mcer12/Hugo-ESP8266/Images/ap_screen.png

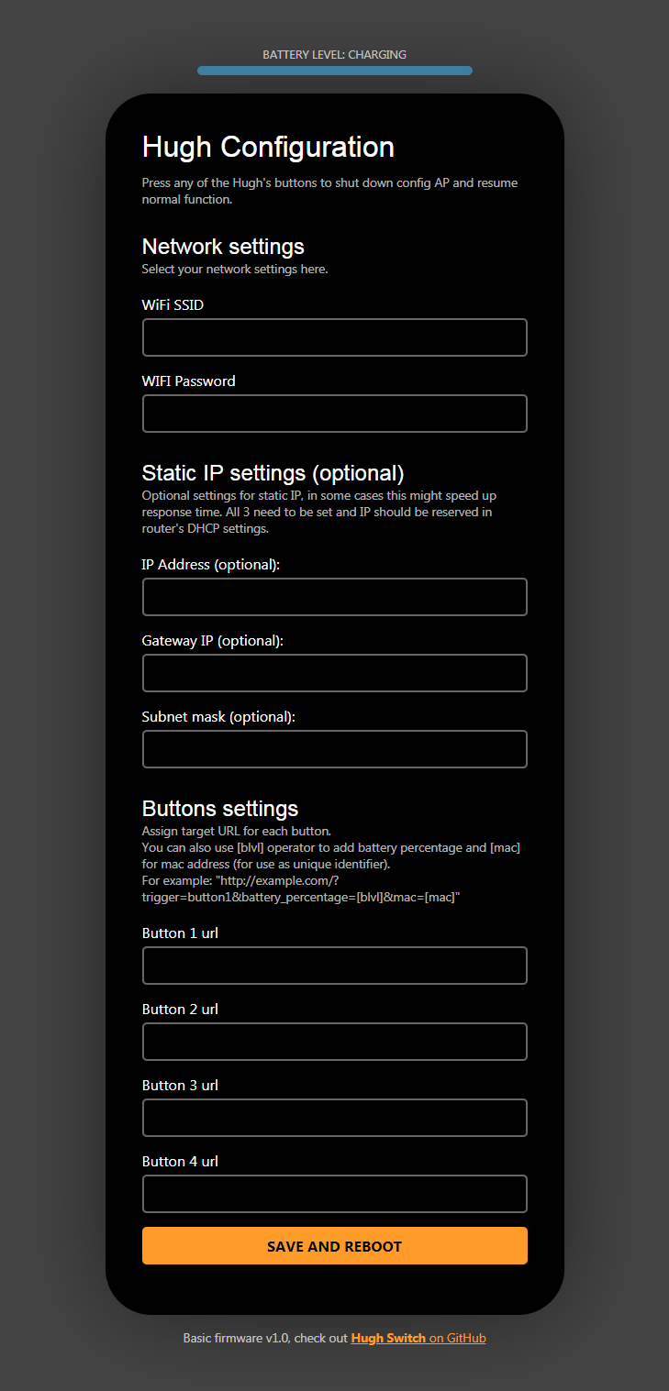
Images/ap_screen.png
