mcer12/Hugo-ESP8266/Images/ide_settings.png

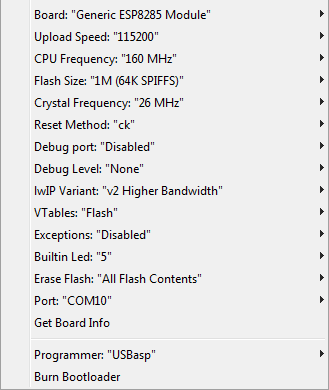
Images/ide_settings.png
