mcer12/Hugo-ESP8266/Images/ide_settings_2.6.3.png

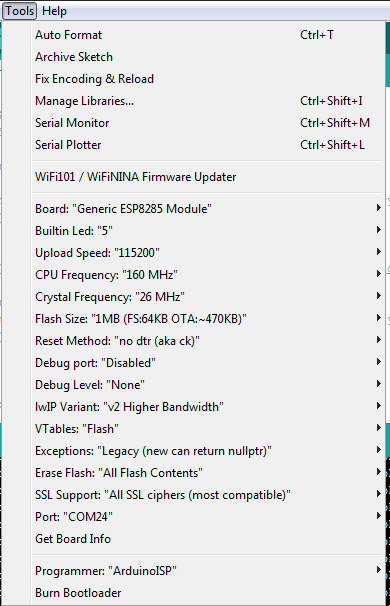
Images/ide_settings_2.6.3.png
