mcer12/Hugo-ESP8266/Resources/hugo_components.xlsx

PCB MARKING | COMPONENT | NOTES | component | pcs needed
ESP-M2 | ESP-M2 |  | ESP-M2 | 1
R1 | 0603 100K |  | 402050 lipo | 1
R2 | 0603 100K |  | CH340E | 1
R3 | 0603 10K |  | 7343 470uF | 1
R4 | - |  | 0603 10uF | 6
R5 | 0603 100K | 4.7uF + 150K combo should work just as well | SOD-323 1N5819 | 14
R6 | 0603 100K |  | 4x4x1.5mm smd button | 4
R7 | 0603 100K |  | TP4056 | 1
R8 | 0603 100K |  | 0603 100K | 6
R9 | 0603 100R-1K | Status led - depends on color of the led (orange, red = 330R) | HT7333 LDO | 1
R10 | 0603 - 4-10K | Charge current adjustment - 5K (recommended) or see table below. Don't use less than 3K otherwise the diode will overheat. | 0603 0.1uF | 4
R11 | - |  | MicroUSB connector | 1
R12 | 0603 100R-1K | battery full led - depends on color of the led (100R-200R for green) | 0603 1K | 4
R13 | 0603 100R-1K | charging led - depends on color of the led (680R-1K for red) | 2N2222 | 4
R14 | 0603 - 10K |  | 0603 1uF | 1
R15 | 0603 - 10K |  | AO3401 | 1
R16 | 0603 - 680K-820K |  | 0603 100R | 1
R17 | 0603 - 200K |  | 0603 330R | 1
R18 | 0603 10k |  | 0603 - 5K | 1
C1 | 0603 0.1uF |  | 0603 - 680K | 1
C2 | 0603 10uF |  | 0603 - 200K | 1
C3 | 0603 10uF |  | 0603 LED ORANGE | 1
C4 | 7343 tantalum 470uF or higher |  | 0603 LED RED | 1
C5 | 0603 0.1uF |  | 0603 LED GREEN | 1
C6 | 0603 10uF
C7 | 0603 10uF
C8 | 0603 10uF
C9 | 0603 10uF
C10 | 0603 0.1uF
C11 | 0603 0.1uF
C12 | 0603 1uF
D0-D13 | SOD-323 1N5819 or similar | for D10 you can use SOD-123 package if using high charge current
T1-T4 | 2N2222 | T3,T4 are optional, only in use with ch340
F1 | AO3401
LDO | HT7333 or similar low quiescent current LDO | MCP1700T is an option
BUTTONS | 4x4x1.5mm smd button (all metal)
LED1 | 0603 LED | status led, GPIO5
LED2 | 0603 LED | battery full led - suggested green color
LED3 | 0603 LED | charging indicator - suggested red
TP4056 | TP4056
CH340E | CH340E
USB | 4 legs through-hole 5pin microusb connector
BATTERY | lipo cells 402050 or smaller
YELLOW = OPTIONAL, USB TO SERIAL CONVERTER
GREEN = OPTIONAL, VOLTAGE DIVIDER FOR BATTERY MANAGEMENT
ORANGE = BUTTONS
RPROG (k) (R10) | IBAT (mA)
10 | 130
5 | 250
4 | 300
3 | 400
2 | 580
1.66 | 690
1.5 | 780
1.33 | 900
1.2 | 1000
