mcer12/Hugo-ESP8266/(threads)

Thread 6 (2019-08-09):

Battery reporting topics

giddyhup, 2019-08-09:
Great soft- and hardware! Apparently, a Hugo reports its battery level under two topics, is this on purpose? Also, 0x3e is 62 not 90, what does it stand for?

```
esp/hugh/battery 3e
esp/hugo/battery 90

```
I use two Hugos. It would make sense to have the status topics configurable through the web interface.

mcer12, 2019-08-13:
Sorry for getting back to you so late, I didn't receive a notification... this is a bug and will be solved in the upcoming update. I'll comment here once its pushed in the git.

mcer12, 2019-08-17:
@giddyhup This should also be fixed with the latest sketch.

giddyhup, 2019-08-17:
Thanks for the update. The line `publishBatteryLevel();` is missing in the code for button 1.

mcer12, 2019-08-17:
Thanks, you're correct. I pushed your solution.
I will add an option for custom topic in the next update.

giddyhup, 2019-08-18:
Good idea. In my case I named my two Hugos (red and black) and put the respective names in the topics.

mcer12, 2019-08-24:
@giddyhup Check out the latest update, it's a bigger one.

giddyhup, 2019-08-24:
Thanks. I will check it out when I return from my trip in a couple of weeks. Meanwhile, I'll close this issue.

Closed 2019-08-24.

Thread 8 (2019-08-26):

Hugo_MqttTrigger Access Point connection error

dimosap, 2019-08-26:
Hello,

I am a fan of your work and i'm testing your Hugo_MqttTrigger code on an esp12e module i own. Unfortunately i have the following problem. The access point appears only for some seconds and i'm not able to connect to it. After that it disappears from the available networks. Any ideas on the cause of this?

Thank you in advance.

mcer12, 2019-08-26:
Hi, this is very unusual and I didn't encounter anything like that. Few things to check off the top of my head.
1. Did you erase flash (all flash contents) when flashing the esp?
2. Are u using sufficient and stable power supply?
3. Is it possible the device you're using to connect to the AP is at fault? Try different one.
4. Do you have a nodemcu/wemos devboard at hand to try the sketch on? Just to check if the issue is not with the module.

I don't know the hookup scheme you have so it's really difficult to pinpoint what might be the issue. Try the above suggestions and if that doesn't help, try to provide me more details on your setup.

mcer12, 2019-08-26:
Oh and it can be caused by the button being still pushed down, for whatever reason. Maybe you didn't hook up the buttons at all and they are floating, maybe you have too large capacitor and it keeps the button pushed for too long. After 3 seconds after starting the config AP, program checks the buttons and if any of them is pushed, AP shuts down.

dimosap, 2019-08-26:
Thanks for your fast response,
I program the esp12e through an FTDI. I don't use other parts but only an ams1117 and buttons. I've also tested it with a nodemcu and a different device to test the connection but i came across the same results.

mcer12, 2019-08-26:
Did you check out my second post too? I think it's very likely to be the issue. Maybe try the buttons without the capacitor and make sure the pulldowns are in place. You will have to hold a button for half a second for it to get recognised but if my theory is correct, the AP won't disappear. This would mean the capacitance is too high, also esr can come into play here so use ceramics.

dimosap, 2019-08-26:
It finally worked!!!
The problem was that I had not connected all the buttons. Now I need to figure out where to put the link from ifttt trigger in the Hugo Configuration.
Thank you a lot for your help, your work is amazing!

mcer12, 2019-08-26:
Glad I could help!

Closed 2019-08-26.

Thread 9 (2019-08-27):

MQTT TLS support

juzam, 2019-08-27:
First of all, thanks for this nifty little gadget, I really like mine. I'm using it with the MQTT firmware 1.3b which added username and password support.

My only desiderata at this point would be support to connect to a secure MQTT broker (with optional client verification).

Would it be hard to implement this? more importantly, would it fit in the maximum space/memory constraints?

Thank you again for your time and effort spent on the project.

mcer12, 2019-08-27:
Hi @juzam I don't currently have the means to do this, I don't use tls at home, I have separate wifi network for IoT so I don't really have a reason to. But it shouldn't be too difficult to implement, it should fit since current sketch uses only around 40% memory but OTA will probably not work since it needs 50% free space. Check this out:
https://github.com/knolleary/pubsubclient/issues/462
Of course any contribution is appretiated!

juzam, 2019-08-27:
Thanks for providing that link, I think I can do some tests with that. I'll report here my findings.

mcer12, 2019-10-10:
Hi @juzam have you made any progress with the TLS?

juzam, 2019-10-10:
I'm so sorry but I didn't have any spare time to work on TLS support.  What I've seen from the link you posted is that `WifiClientSecure` could be an almost drop-in replacement for `WifiClient`. I hope to get some spare time during the weekend to do some tests in that regard.

juzam, 2019-10-21:
I had some time to work on this during the weekend but I still don't have anything usable. I've also realized that having just one remote doing the compile/upload/reconfigure/test cycle is very time consuming. I'm waiting for an esp8285 to be delivered to ease the process.

meanwhile I've setup up a fresh mosquitto broker with let's encrypt certificates to start with a clean slate.

mcer12, 2019-10-21:
@juzam you can use any ESP8266 module or devboard, it's fully compatible with esp8285 ;)

juzam, 2019-12-16:
a little update. I'm stuck at not being able to connect to a tls secured broker. I've tried a simple apporach with a very stripped down arduino sketch to no avail. What I'll do next is take a closer look on how `Tasmota` deals with mqtt and tls. They are using ``` #include <t_bearssl.h>``` to do so.

also, apologies for my perennial lack of time to work on this.

Darkmelman, 2020-08-13:
@juzam and @mcer12 Some time ago I implemented a very similar project myself with an Adafruit Huzzah32 and tls support. I think you could take over the parts of the source code that concern tls and WifiClientSecure

[https://github.com/Darkmelman/mqtt_button.git](url)

As soon as I have the time, I will be happy to support you

mcer12, 2020-08-13:
Hopefully @juzam will be able to use that, thank you for the hint! Though I don't use TLS in mqtt and don't have time to dig into it, I will accept PR if you decide to contribute!

I see you use adafruit mqtt library, did you have any particular reason for that? I ask because this would probably not fit within ESP-M2 memory together with pubsub client and it would have to be made as a separate sketch ;) I had to optimize quite a bit to squeeze HTTP + HTTPS capability in url trigger sketch.

Thread 11 (2019-10-27):

RFE : include printed MAC address on devices, web config interface

MagicFab, 2019-10-27:
It would be very useful to know the MAC address in order to be able to assign a static IP address before the first connection.
I'd like to suggest including the MAC address of each device in printed documentation or sticker on the device/static bag it comes in. This should also be displayed in the Hugo web configuration.

mcer12, 2019-10-27:
Hi @MagicFab at this point, the MAC address is appended to OTA name, I think the easiest approach is to append lets say last 6 characters to config SSID. Something like HugoXXXXXX instead of HugoConfig.
I will close the issue and let you know once it's done.

MagicFab, 2019-10-28:
Sorry I wasn't clear, I was not referring to the OTA name but to actually showing it in the web UI at http://10.10.10.1.

mcer12, 2019-10-28:
Yes this is a good idea, I will add it somewhere in the config portal.

mcer12, 2019-10-30:
MAC address was added in config portal as well as in config portal SSID, check out latest fw!

MagicFab, 2019-10-31:
Thank you! I've upgraded the firmware on one of the remotes I have and the MAC address is now show, most excellent!

Closed 2019-10-30.

Thread 13 (2019-10-27):

Battery topic is not included in the discovery (doHassRegister() ) function

mikeage, 2019-10-27:
Calling doHassRegister() sends a config topic for the state, but doesn't include battery information.

I'll try to submit a PR once I get an environment for flashing set up.

mikeage, 2019-10-27:
I'm having trouble flashing a new version (see #14 ), but here's a discovery string sample for battery (assuming the default topics); this one should be posted to `homeassistant/sensor/hugo_bd2916/battery/config`
```
{"unit_of_measurement":"%","device_class":"battery","state_topic":"homeassistant/sensor/hugo_bd2916/battery","name":"Hugo bd2916 Battery","unique_id":"hugo_battery_bd2916","device":{"ids":"hugobd2916","name":"Hugo - WiFi remote","mf":"https://github.com/mcer12/Hugo-ESP8266", "mdl":"Hugo-ESP8266","sw":"1.3"}}'
```
This is in conjunction with a regular discovery string of:
```
{"unique_id":"hugo_bd2916","name":"Hugo bd2916","stat_t":"homeassistant/sensor/hugo_bd2916/state","ic":"mdi:remote","exp_aft":"1","device":{"ids":"hugobd2916","name":"Hugo - WiFi remote","mf":"https://github.com/mcer12/Hugo-ESP8266", "mdl":"Hugo-ESP8266","sw":"1.3"}}
```
The device ID is the same, so they're linked in HA, but there's a unique `unique_id` for the battery sensor.

mcer12, 2019-10-27:
Hi @mikeage yes, currently battery state is not included in the discovery, this is one of the priorities for the next release. It should be ready sometime during next week, will keep you posted.

mikeage, 2019-10-27:
Ok, cool. Figured  I’d try to help a bit, but I’m not yet at the stage to submit a PR...

mcer12, 2019-11-03:
Check out latest commit, all you have to do is register Hugo again for it to update the configuration. Your suggested payload was a great help.

Closed 2019-11-05.

Thread 14 (2019-10-27):

Trouble flashing OTA

mikeage, 2019-10-27:
Hi,
I realize this might be a generic Arduino question; most of my experience is with platformio, and I'm not completely comfortable in the Arduino GUI.

I've made a small change to the code, compiled it, put the Hugo into OTA mode by pressing buttons 1+3 (rapid flashing), selected the network port, and selected Upload in the GUI. It says it's uploading, the LED becomes solidly lit, and then the Arduino GUI reports upload complete, but the LED stays lit and it seems like it did not accept the new .bin. If I push a button, any button, it seems to restart, but it does not appear to have loaded the new SW (tested by updating `#define FW_VERSION` and pressing buttons 2+4 to send the config string.

Any idea what I might be missing?

mcer12, 2019-10-27:
After the OTA finishes, it can still be processing the binary for few seconds. Just to be sure, by "not appear to have loaded the new SW" you mean the device is unresponsive or just acts like nothing happend?

mikeage, 2019-10-27:
I mean it stays with the LED lit for a while. If I press a button, it sends MQTT messages again, but with the old FW VERSION string.

mcer12, 2019-10-27:
Can you try to flash it again with the OTA? It might've been some kind of unusual hickup, usually if the OTA fails the device crashes. Also make sure to double chceck if all the options correspond with wiki page, if the settings were set wrong, binary might've been refused by the device:
https://github.com/mcer12/Hugo-ESP8266/wiki/Flashing-&-FW-update

Let me know how this goes, hopefully all is OK. Keep in mind though that OTA can fail from time to time and brick poor Hugo and since you have a version without CH340, this can get annoying :)

mikeage, 2019-10-27:
Sure (but probably not until tomorrow). I’ll let you know.

mcer12, 2019-11-03:
In case you didn't have time to try it out yet, check out latest commit, might interest you.

mikeage, 2019-11-03:
Thanks, I saw! I got pulled out of town on short notice and am now 2000km away from my devices :)

Closed 2020-07-20.

Thread 15 (2019-10-28):

Trouble registering Hugo to diyHUE/Hue app  - docs refers to "Sensors" section but there isn't any in the Hue app

MagicFab, 2019-10-28:
The documentation for pairing a Hugo remote with diyHue indicates:

> Push and hold buttons 2 + 4 until the led lights up, and release. This will register the remote in diyHue and it will pop up in Hue app, in Sensors section.

When I push and hold buttons 2 + 4 (assuming button "2" is under "O" and "4" is "I"), the led starts flashing fast. Is this indicating a registration attempt ?

The diyHue IP is properly configured in the Hugo remote. I was able to import lights into it from an existing Philips Hue bridge. I am not sure what is meant by "This will register the remote in diyHue", it doesn't show up anywhere I can see in the web UI. Can you provide more details ?

Regarding the Pillips Hue app, there isn't a "Sensors" section, only "Your rooms" in the Home section and "Accessory setup" under Settings. Could you please confirm where this is supposed to show up on the latest version of the app ? I tried 3.20.1.7162 and 3.31.0.7477.

mcer12, 2019-10-28:
Hi @MagicFab Do you use diyhue emulator or original hue bridge? Not sure how you come up with the numbering but the buttons are numbered from top to bottom so "I" is button 1, "O" is button 4 :) I will add this to wiki.

Yes Accessory is the correct menu. There might've been a change in Hue app, it was Sensors before.

MagicFab, 2019-10-28:
OK, thanks for clarifying the buttons. Perhaps the initial config/wifi connection can be a common section in the main documentation page where there is a picture, and identify the buttons on the picture. I am attaching such a miodified image, it's a GIMP XCF document with layers which you can modify (zipped, apparently Github doesn't like XCF) and a rendered jpeg image.

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

[hugo-buttons.zip](https://github.com/mcer12/Hugo-ESP8266/files/3779265/hugo-buttons.zip)

I am using diyHue as I don't expect the remote to register and show up on the other which is a the Philips bridge hardware device. In the Hue app both bridges are registered but I am connected to the diyHUe.

mcer12, 2019-10-30:
Double check if you entered the correct bridge IP and you are on the same network. Then push and hold buttons 2 and 4 until the led lights up for a second. Then it should pop up in the Hue app. Let me know how it goes.

mcer12, 2019-10-30:
I personally use diyhue at home so I've done this for all my remotes without issues. I would also check if the diyHue bridge is reachable using the IP address.

MagicFab, 2019-10-31:
Ok, so I had some time to check this again today.

After upgrading firmware for 2 of my devices and connecting them I tried the above with Philips Hue app and Hue essentials on one device. The remote appeared in both apps in the diyHUE, but not in its web interface (I don't think the UI shows any remotes)!

It appeared as a Hue Tap Switch under Settings > Accessory Setup. It's not ideal as it is a round-shaped remote, buttons 1,2,3 and 4 matched the same on Hugo and I was able to program them.

Another interesting fact, once I was finished I picked the other remote to set it up and when I touched button 1 it turned on the light... same as the other remote. The second remote is programmed the same as the first, yet it wa not registered to Hue. It seems the app thinks both remotes are the same (mirrored?).

I'll file a separate bug report, this one should be closed now. Thank you!

mcer12, 2019-10-31:
That would mean the remotes have the same MAC address which seems extremely unlikely. Maybe since you don't have it registered, diyHue doesn't know what to do and uses one of the already registered remotes. Try to register the second remote if you didn't do so already, that should solve it.

MagicFab, 2019-10-31:
OK, I'll be able to try that tonight - thanks!

mcer12, 2019-11-05:
Have you had time to try it out? If it's working as intended, please close the issue.

MagicFab, 2019-11-05:
Yes, I've tried this again after removing the registered remote and was unable to register either one of the remotes I have. I can't register it again, despite completely resetting both Hue bridge and diyHue bridge configurations completely and reflashing the devices. This worked once, never again.
What is the recommended way to reset the remote ? Is re-flashing enough ?

mcer12, 2019-11-05:
Oh I get it now! You don't have to reset the remote at all, this is diyHue issue with any remote (not just Hugo). Once you remove a remote from the app, it is still present in the diyHue config file. You have to manually remove the rmotes from diyHue file to *really* remove them and be able to register them again.  Wonder why this is still not fixed, I will add an issue on diyHue github page.

mcer12, 2019-12-16:
@MagicFab Latest diyHue version shoudl fix it but you will still have to remove the remotes from the config file or reset the diyHue to factory config.
https://github.com/diyhue/diyHue/commit/2c488808528924cd427f18bc9d473a76abd349b1

MagicFab, 2019-12-16:
OK, I never thought it would be a diyHue problem! I will be trying this again shortly - thank you!

Closed 2019-12-16.

Thread 22 (2019-11-05):

Button press issue

user-hash, 2019-11-05:
Hey, just got Hugo today and I entered the config details normaly.
I got the mqtt working, but since I was just trying I didnt know which button is which, so I decided I will upload the code again, to add diffrent button topics and such.
Code uploads normaly, and I can enter the config screen and set the information, but when remote reboots, its only registering combo button presses, even if 1 button is pressed.
Any ideas how can I solve this?

Here is the debug code I get, if I press the buttons from 1-4 in slow sequence, no combo button presses.
https://pastebin.com/wYSQja4F

mcer12, 2019-11-05:
Hi, this definitely shouldn't be happening. How fast are you pushing the buttons? You should make at least 1s delay between pushes, otherwise it can register it as a combo.

user-hash, 2019-11-05:
Please check the pastebin I posted above.
I press a single button 3 seconds after I get the "going to sleep" messege in the serial.
It only detects combo messeges..I can also record video, if you need it

mcer12, 2019-11-05:
In that case I suspect a hardware issue. This shouldn't be happening, please email me to investigate this further.

user-hash, 2019-11-05:
Hey, I hope you get this email, please confirm.
What information do you need from me?
Matic

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

Closed 2019-11-05.

Thread 25 (2019-12-05):

MQTT / Home Assistant / button topics

Zixim, 2019-12-05:
Hello,

just got 2 Hugos in the mail! I'm really chuffed, they feel like great little devices.

I flashed the MQTT firmware, made sure HA MQTT is configured for discovery (which it wasn't), and the Hugo device shows up under Integrations/MQTT in HA Configuration.
There's 2 entities , one for the status of the Hugo and one for the Battery.

I do have a couple of questions though:

Aren't all configured buttons supposed to show up in there ?
Why is the sensor for battery not showing any value ?

mcer12, 2019-12-05:
1) what do you mean by all buttons? Do you mean remotes or individual buttons on a single remote?
2) It only updates battery status together with a button topic. Maybe you didn't set up battery topic in web config?

Zixim, 2019-12-05:
I mean individual buttons, which I all set up in the web config as shown :

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

The button presses show up in MQTT Lens , as expected :
with topic `homeassistant/sensor/hugo_XXYYZZ/btn1` and payload `1`

The battery value never updates, and stays empty even after button presses.

mcer12, 2019-12-05:
You have to use example topics for all button topics as well as for battery topic for Home Assistant integration to work. See wiki:
https://github.com/mcer12/Hugo-ESP8266/wiki/Sketch:-MQTT
"homeassistant/sensor/hugo_[id]/state" for the buttons
"homeassistant/sensor/hugo_[id]/battery" for battery
I will add the note in config portal as well for more clarity in an upcoming update.

Zixim, 2019-12-05:
So the web config states :
`Assign MQTT Topic and Payload for each button, for example:
Topic: "homeassistant/sensor/hugo_[id]/state"
Payload: "1" `

What does that mean I should set for Button 1 topic & payload ?
And what about Button 2?

mcer12, 2019-12-05:
Don't overthink it, it's meant to be simple :)

B1
topic: homeassistant/sensor/hugo_[id]/state
payload: 1

B2
topic: homeassistant/sensor/hugo_[id]/state
payload: 2

etc......

Zixim, 2019-12-05:
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
Much better 😜

mcer12, 2019-12-05:
It's a common assumption that DIY products have to be difficult to set up, but I disagree :) Glad you managed to make it work! I did some edits to the wiki to make it a bit clearer.

Closed 2019-12-05.

Thread 26 (2020-02-15):

Is this product available anymore

ravi9884, 2020-02-15:
First of all sorry to spam in GitHub issues, but I had no choice as tindie wouldn't send an email to activate my account to contact seller.

I just ordered 3 from tindie, but it ran out of stock. I wanted to buy 2 more. Also, how would I replace the battery? Any link to buy similar battery

Thanks,
Ravi R

mcer12, 2020-02-15:
I believe this was answered on Tindie ;)

Closed 2020-02-15.

Thread 27 (2020-03-02):

Wiki suggestion: a script to make bulk configuration easier

sowbug, 2020-03-02:
It's tedious to configure multiple remotes. I wrote a simple script that makes it a little easier.

```
REMOTES = {
    "12:23:34:45:56:67": 100,
    "12:23:34:45:56:68": 101,
    "12:23:34:45:56:69": 102,
}

PARAMS = {
    "ssid": "myssid",
    "pass": "mypass",
    "ip": "192.168.2.",
    "gw": "192.168.2.1",
    "sn": "255.255.255.0",
    "broker": "192.168.2.100",
    "port": "1883",
    "mqttusr": "mqttusername",
    "mqttpass": "mqttpass",
    "b1t": "homeassistant/sensor/hugo_[id]/state",
    "b1p": "payload1",
    "b2t": "homeassistant/sensor/hugo_[id]/state",
    "b2p": "payload2",
    "b3t": "homeassistant/sensor/hugo_[id]/state",
    "b3p": "payload3",
    "b4t": "homeassistant/sensor/hugo_[id]/state",
    "b4p": "payload4",
    "b5t": "homeassistant/sensor/hugo_[id]/state",
    "b5p": "payload5",
    "b6t": "homeassistant/sensor/hugo_[id]/state",
    "b6p": "payload6",
    "b7t": "homeassistant/sensor/hugo_[id]/state",
    "b7p": "payload7",
    "batt": "homeassistant/sensor/hugo_[id]/battery",
}

import copy
from urllib.parse import urlencode

for mac, ip in REMOTES.items():
    p = copy.deepcopy(PARAMS)
    p["ip"] += str(ip)
    print("%s: curl -d \"%s\" 10.10.10.1\n\n" % (mac, urlencode(p)))
```

This will spit out a bunch of `curl` commands you can execute on the command line when you're connected to a remote in configuration mode. The curl command is the same as filling out the web form and hitting submit. As you can see, my remotes are flashed with the MQTT firmware. Modify the script for other kinds.

mcer12, 2020-03-02:
Hi @sowbug I like the idea but I wonder how do you find out mac address before you connect to the network? Probably it can be found in debug console but that doesn't seem to simplify things. Can you elaborate on the process?
What I do when I want to set up multiple remotes fast is connect to a remote in AP mode, save config and leave the config page open (with fields already filled in). Connect to another remote and just hit save. And repeat.

sowbug, 2020-03-03:
It's a two-pass operation. First, connect to each one and paste the MAC addresses into the script. Then start over again from the beginning and run the right generated curl script. Yeah, painful, I know.

I also started with the recycled web form, but once or twice I pressed submit a moment too early, before I'd gotten the DHCP assignment, and my browser wiped out all the fields. So I wanted something a little more predictable (including if I wanted to reflash the firmware in the future). Plus for various reasons it was helpful to have the list of MAC addresses when setting up the static addresses in my router, so once I compiled the list and noticed it looked a lot like a Python dict, the rest was quick.

To be clear, I'm not proud of this solution. But it did work!

Maybe a compromise would be an optional field on the form where you could paste JSON. You already have imported ArduinoJSON in the MQTT client, so it's not going to change the firmware size significantly.

mcer12, 2020-04-14:
Sorry to get to this so late, I will try to add a field for raw json in some reasonable way.

Now that I think about it, maybe it would be best to make two more url paths
**/download_json**
**/import_json**
One with a textarea where you can paste the json and second that will just return raw json content that you can download. Root / will return the config website as usual

sowbug, 2020-04-14:
Cool, no hurry for me in particular -- mine are set up and working fine.

Closed 2023-05-31.

Thread 28 (2020-05-23):

ESPHome Support

oldgeezy, 2020-05-23:
I just converted a bunch of my Tasmota devices to ESPHome, which looks like a great platform for managing all your ESP devices and OTA updates.  Is there any way we could get firmware support there for our switches?

mcer12, 2020-05-25:
Hi, since there are some unusual hardware specifics (buttons connected to wakeup, capacitors on buttons etc), you can't use ESPHome fw as is, you would have to make your own custom sketch to accomodate the above. If you would like to contribute with an ESPHome sketch, I will accept PRs, but I don't have the time to learn ESPHome as I don't personally use that platform at home... hope you understand :)

That said, if you use ESPHome with Home Assistant, you can use the MQTT sketch which works pretty well with HASS including auto-discovery.

Closed 2020-09-08.

Thread 30 (2020-07-20):

Suggestion

StefanRehnberg, 2020-07-20:
Hi
It would be a very nice feature if you could implement "multi click" on the buttons, like the [Shelly i3](https://shelly.cloud/knowledge-base/devices/shelly-i3/).

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

mcer12, 2020-07-20:
Hi @StefanRehnberg this is sadly not possible. It's not possible because of HW reasons, in the way it works, it is impossible to distinguish between longpress and two quick presses. And even if it was possible, this would lead to worse battery performance since the remote would have to wait for possible second push every time. That said, I am planning on adding a long press (which is long overdue) which I think is going to give you plenty of options. At this point, there are single pushes and two-button combos, so 7 possible functions. With longpress it will go up  to 11 :)

StefanRehnberg, 2020-07-21:
Excellent! thanks for the info, keep up the good work :-)

Closed 2020-07-21.

Thread 32 (2020-09-11):

HTTP (Basic URL trigger)

patrickdej, 2020-09-11:
Hello,
we have inserted an URL into the Hugo, but the request is executed as a TCP message and not as an http request (seen in wireshark)
Whats wrong?

URL set to this http://172.20.20.153:8080/#/Main/Acknowledge?Sendkey=T1_S1_G
when executing this URL from an phone on the same network (just past it into the browser), it works fine.
so no issue on firewall.
172.20.20.122 is the phone, TCP connection OK, http OK
172.20.20.170 is the Hugo ==> TCP NOK and thus no http transfer possible
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

thanks,

Patrick

mcer12, 2020-09-11:
Hi, I think this might have something to do with the port in your URL address. I never tried/needed this so this is probably what's the issue here. Lets start by removing the port from the URL address (so it will be 80 by default), see if it works.

patrickdej, 2020-09-18:
OK, works fine now. was due to the way the website worked, it needed more then only 1 url...
thanks!

Closed 2020-10-25.

Thread 33 (2021-01-08):

change firmware from URL to MQTT

patrickdej, 2021-01-08:
Hello,

We have been using the HUGO with the URL triggering and is working fine.
When we now want to change the firmware to the MQTT version, we get the following output, if we flash the URL version, all works fine. I'm quiet new to this, any direction where to go for finding a solution?

--------------- CUT HERE FOR EXCEPTION DECODER ---------------#LF#CR#LF ets Jan  8 2013,rst cause:2, boot mode:(3,7)#CR#LF#CR#LFload 0x4010f000, len 3584, room 16 #CR#LFtail 0#CR#LFchksum 0xb0#CR#LFcsum 0xb0#CR#LFv2843a5ac#CR#LF~ld#LF#CR#LFFW: MqttTrigger#CR#LFButton: 0#CR#LF#LF--------------- CUT HERE FOR EXCEPTION DECODER ---------------#LF#CR#LFException (28):#CR#LFepc1=0x4020554a epc2=0x00000000 epc3=0x00000000 excvaddr=0x00000000 depc=0x00000000#CR#LF#CR#LF>>>stack>>>#CR#LF#CR#LFctx: cont#CR#LFsp: 3ffffd80 end: 3fffffc0 offset: 0190#CR#LF3fffff10:  3fffdad0 3fff0618 3fff06f8 40205539  #CR#LF3fffff20:  feefeffe feefeffe feefeffe feefeffe  #CR#LF3fffff30:  feefeffe feefeffe feefeffe feefeffe  #CR#LF3fffff40:  feefeffe feefeffe feefeffe feefeffe  #CR#LF3fffff50:  feefeffe feefeffe feefeffe feefeffe  #CR#LF3fffff60:  feefeffe feefeffe feefeffe feefeffe  #CR#LF3fffff70:  00000000 00000000 3fff185f 3fff185f  #CR#LF3fffff80:  00000000 feefeffe feefeffe feefeffe  #CR#LF3fffff90:  feefeffe feefeffe feefeffe 3fff0828  #CR#LF3fffffa0:  3fffdad0 00000000 3fff07e8 4020defc  #CR#LF3fffffb0:  feefeffe feefeffe 3ffe84f4 40100da9  #CR#LF<<<stack<<<#CR#LF#LF--------------- CUT HERE FOR EXCEPTION DECODER ---------------#LF#CR#LF ets Jan  8 2013,rst cause:2, boot mode:(3,7)#CR#LF#CR#LFload 0x4010f000, len 3584, room 16 #CR#LFtail 0#CR#LFchksum 0xb0#CR#LFcsum 0xb0#CR#LFv2843a5ac#CR#LF~ld#LF#CR#LFFW: MqttTrigger#CR#LFButton: 0#CR#LF#LF--------------- CUT HERE FOR EXCEPTION DECODER ---------------

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

regards,

patrick

mcer12, 2021-01-08:
I bet it's crashing because you don't erase whole flash :) So first change Erase flash to "all flash contents". In case I'm wrong, you might have some outdated libraries or ESP8266 board definition so check if you have the latest versions.

mcer12, 2021-01-08:
Also set frequency to 160MHz, the performance should be better.

mcer12, 2021-03-08:
Closing as stale, feel free to reopen.

Closed 2021-03-08.

Thread 35 (2021-01-30):

DHCP does not wait long enough

hagenbuch, 2021-01-30:
Dear Mcer12,

I am using 4 of your Hugos (firmware 1.4.1) on a regular basis and it works mostly fine, but -

While using it (over time) with two different Wifi routers from the same manufacturer (AVM, Fritzbox 7430 and 7530 - the last is very modern) the device seems to not wait long enough for the DHCP reply so it blinks instead of sending data. This happens every 1 in 5 times, no matter how distant I am.

I have seen that the timeout is hardcoded in your main code (4 and 8 seconds?) I am not proficient enough to write a pull request but you might figure this out in seconds.

I understand that you don't want to wait for too long because it affects battery life. However, I would really appreciate if this timeout could be configurable in the webfrontend or at least could be set as global variable in the code.

I hope that makes sense for you, too :-)

Thank you for your product and for taking your time..
Andreas

mcer12, 2021-01-30:
It should not take so long to receive DHCP. I would guess something with the network is the culprit. Have you tried static IP?

mcer12, 2021-03-08:
Closing as stale, feel free to reopen.

Closed 2021-03-08.

Thread 36 (2021-05-25):

Possibly release gerber files now that product is retired?

nullstalgia, 2021-05-25:
I forgot to grab one while the last batch went up, and I wanted to maybe yoink the design you had.

If not, that's fine! Just thought I should ask. <3

mcer12, 2021-05-28:
I added the gerber, with all the usual disclaimers. But to be honest, at this point it makes more sense to use ESP32 as it has more GPIOs, much easier to work with deepsleep and it has half the power consumption in deep sleep. You can compensate for the ESP32 size with smaller component count. I personally switched over to ESP32 for most projects, except when I need it super tiny, where ESP-M2 makes more sense.

Closed 2021-05-28.

Thread 37 (2022-02-19):

not an issue, more a plea : Revive this project with esp32-c3 ?

Zixim, 2022-02-19:
The title says it all really...
There's this thing : https://github.com/makermoekoe/Picoclick-C3 , but it's far from user-friendly.
I've been using your Hugos for a few years now, and they're easy to config, run rock solid, integrate great with Home Assistant. No complaints at all.

So, a more modern esp32-c3 version, please ?

mcer12, 2022-02-20:
Hi, I don't see any issue with using ESP8266 - my hugos run prefectly fine and I don't see any meaningful benefit by using ESP32. If the ESP32 was 5GHz capable, that would be a different story.

That said, you can make the board yourself if you can solder, gerber, BOM and schematic are all in this repository :)

Zixim, 2022-02-20:
i'd prefer to purchase...8266 or 32 are equivalent in this usage case that's true.

ceoloide, 2022-02-21:
Shameless plug: a while ago I created an ESP-32 derivative of Hugo-ESP8622, aptly named [Ugo-ESP32](https://github.com/ceoloide/Ugo-ESP32).

That board uses a [TinyPICO](https://www.tinypico.com/) module, which uses almost no battery on low power mode. With a 1200mha battery I could get almost 2 years of standy time and over 500 button presses.

The ESP-32 gives more flexibility with encryption, so it supports both HTTPS and MQTTS endpoints at the same time.

JLCPCB now offers a wider variety of components for their SMD servive, so in theory one could order the Hugo-8266 through them directly and have it fully assembled.

Zixim, 2022-02-21:
This Tinypico thing is expensive - 22 usd ??

About JLCPCB + Hugo-ESP8266, I'm very tempted, but this is entirely new to me.
Even going through [the instructions included in Gerber_Hugo-ESP8266.zip](https://docs.easyeda.com/en/PCB/Order-PCB/), I'm left with way many questions, leading me to believe I'll never end up with a few useable devices.

I mean...it says : `1. Finish the schematic and PCB design at EasyEDA.`
But EasyEDA doesn't let me import the gerber files...

Slightly demotivated here...

mcer12, 2022-02-21:
You dont unzip the gerber díle, you upload it directly to jlcpcb ;)

Zixim, 2022-02-21:
Yea, that's what the web interface at JLCPCB told me... then it wants a CPL file, which I'm supposed to make in EasyEDA ?

Closed 2022-02-20.
