mcer12/Hugo-ESP8266/Resources/Hugo-ESP8266_schematic_2.3.pdf

## Voltage measurement

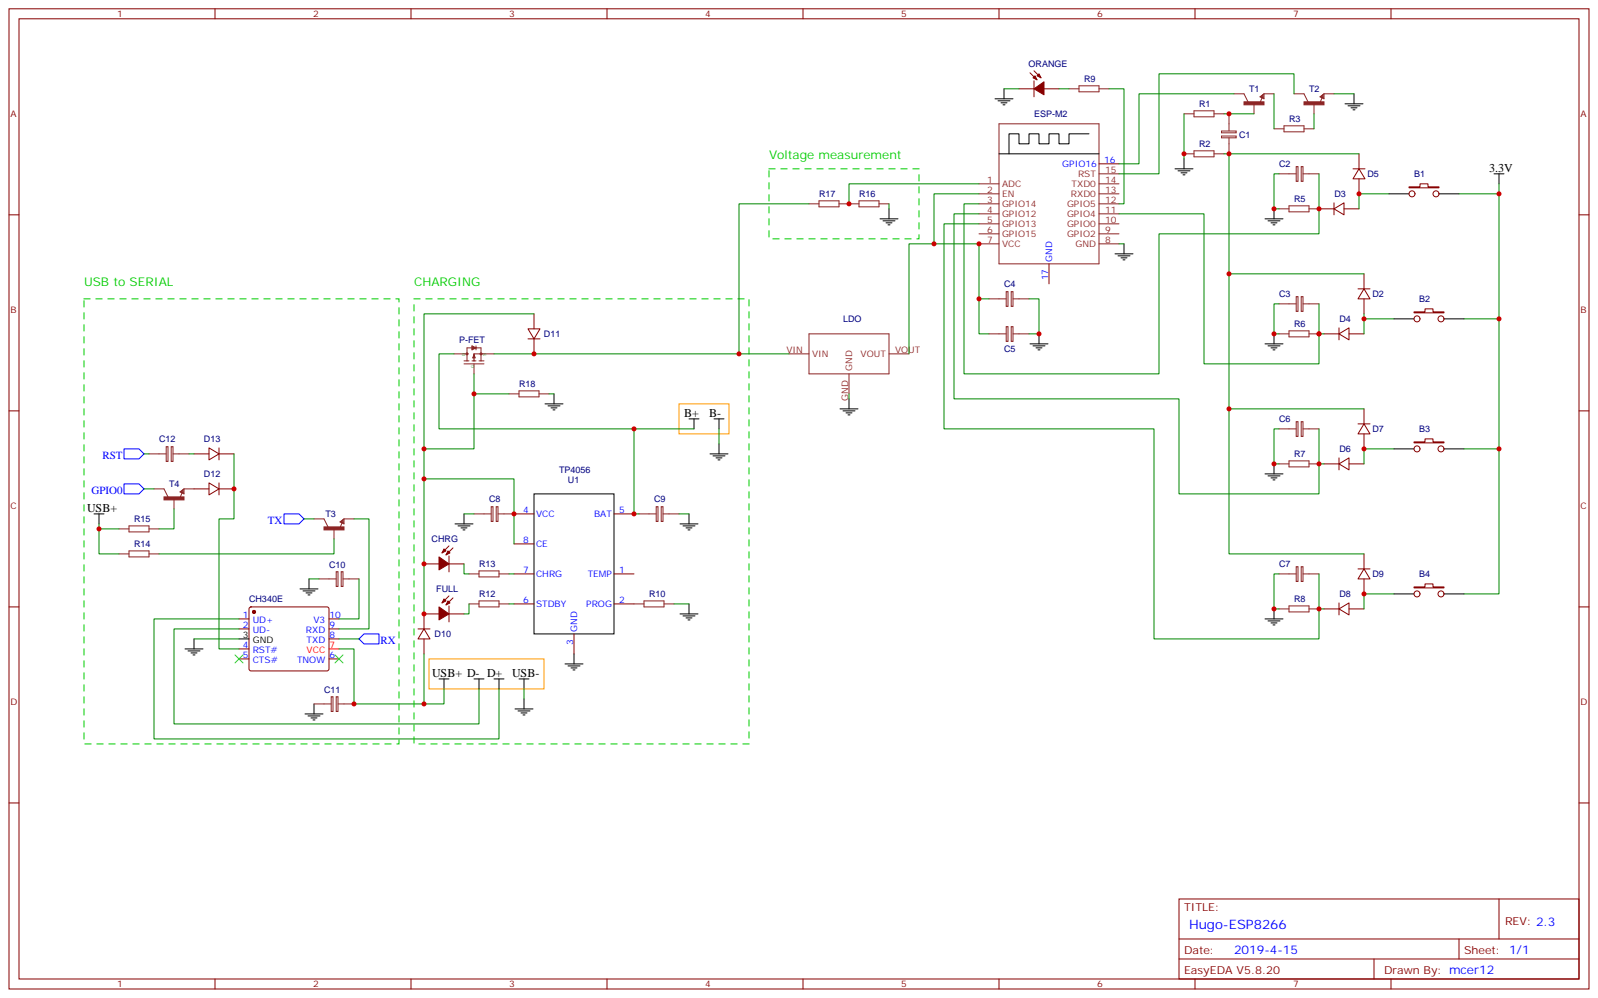
[picture p5: page 1]

GPIO13 5
GPIO15 6
