mcer12/Hugo-ESP8266/Firmware/HugoRGB_MqttTrigger/ota.ino

void setupOTA() {
  String ota_name = OTA_NAME + macLastThreeSegments(mac);
  ArduinoOTA.setHostname(ota_name.c_str());
  ArduinoOTA.begin();

  ArduinoOTA.onStart([]() {
    Serial.println("OTA UPLOAD STARTED...");
    stopBlinking();
    digitalWrite(5, HIGH);
  });

  ArduinoOTA.onError([](ota_error_t error) {
    (void)error;
    ESP.restart();
  });

  ArduinoOTA.onEnd([]() {
    Serial.println("OTA UPLOAD DONE...");
  });
}

void startOTA() {
  startBlinking(OTA_BLINK_SPEED);
  delay(5000);
  while (millis() - otaTimer < OTA_TIMEOUT) {
    if (digitalRead(button1_pin) == HIGH || digitalRead(button2_pin) == HIGH || digitalRead(button3_pin) == HIGH || digitalRead(button4_pin) == HIGH) {
      stopBlinking();
      goToSleep();
      return;
    }
    ArduinoOTA.handle();
    delay(20);
  }
  stopBlinking();
  goToSleep();
}

void toggleOTAMode() {
  if (digitalRead(button1_pin) == HIGH && digitalRead(button3_pin) == HIGH) {
    int i = 0;
    while (digitalRead(button1_pin) == HIGH && digitalRead(button3_pin) == HIGH && i < 200) {
      delay(10);

      if (i > 100) {
        deviceMode = OTA_MODE;
        otaTimer = millis(); // start counter
        return;
      }
      i++;
    }
  }
}
