mcer12/Hugo-ESP8266/(commit log)

2019-05-19 added battery level measurement
2019-05-19 removed serial prints, changed serial speed
2019-06-02 1. Wifi WL_CONNECTED checking hotfix, 2. diyHue sketch update, register function added, push and hold buttons 1 and 3 to add remote in Hue app
2019-06-03 1. Wifi connection timeout set to 4 seconds - this fixes "failed to connect" bug, 2. Added mac slip to OTA name to distinguish between remotes, 3. readme added in the sketches
    [Hugh_BasicUrlTrigger.ino, config_portal.ino, fns.ino]
2019-06-03 Button discharge hack removed, this can potentially damage GPIO
    [fns.ino]
2019-06-04 fix for AP connection issues on some devices
    [config_portal.ino]
2019-07-13 Device won't go to sleep anymore when new config file is created
    [fns.ino]
2019-07-13 Button combinations added
2019-07-13 config portal typo fix
    [config_portal.ino, fns.ino]
2019-07-13 Button combinations added in MQTT firmware
2019-07-31 components list added, some renaming done
    [hugo_components.xlsx]
2019-08-17 battery level topic fix
    [fns.ino]
2019-08-17 publish battery level when any of the buttons is pushed
2019-08-24 fixed mqtt login issues
    [fns.ino]
2019-08-24 small delay added between button and battery publish
2019-09-08 MQTT connection attempts count fix, other small fixes
    [Hugo_MqttTrigger.ino, config_portal.ino, fns.ino]
2019-09-08 BasicUrlTrigger config portal fix
    [Hugo_BasicUrlTrigger.ino, Hugo_MqttTrigger.ino, config_portal.ino, fns.ino]
2019-10-13 typo fix in config portal
    [config_portal.ino]
2019-10-30 New main image with button numbers
2019-11-02 updated schematic
2019-11-03 Battery added to autodiscovery
2020-02-15 HTTPS fix for latest Arduino IDE + ESP8266 board versions
    [Hugo_BasicUrlTrigger.ino, fns.ino]
2020-04-24 battery parameter changed to support battery monitoring in diyHue
2020-07-28 added 3-blink low battery warning
2021-05-28 added gerber
    [hugo_components.xlsx]
2021-08-30 wifi timeout fix -> changed from 4s to 10s since some routers take long to assign IP address to the ESP. FW Version bump.
    [HugoRGB_MqttTrigger.ino, HugoRGB_diyHueTapSwitch.ino, Hugo_BasicUrlTrigger.ino, Hugo_MqttTrigger.ino, Hugo_diyHueTapSwitch.ino]
2022-10-15 ota function merged with MQTT sketch, MQTT sketch fixed
    [Hugo_BasicUrlTrigger.ino, Hugo_MqttTrigger.ino, ota.ino]
